disposedtrolley/etch-a-sketch/README.md

# etch-a-sketch

STM32-based Etch A Sketch widget with an OLED display and rotary encoders.

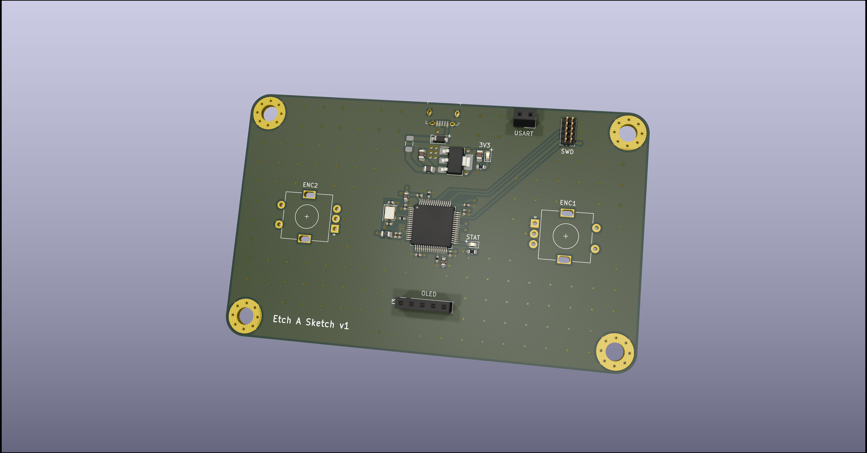
[picture p1: pcb.png]
PCB
