disposedtrolley/etch-a-sketch/Hardware/etch-a-sketch/etch-a-sketch.kicad_pcb

## KiCad design Hardware/etch-a-sketch/etch-a-sketch.kicad_pcb (2020-04-19)

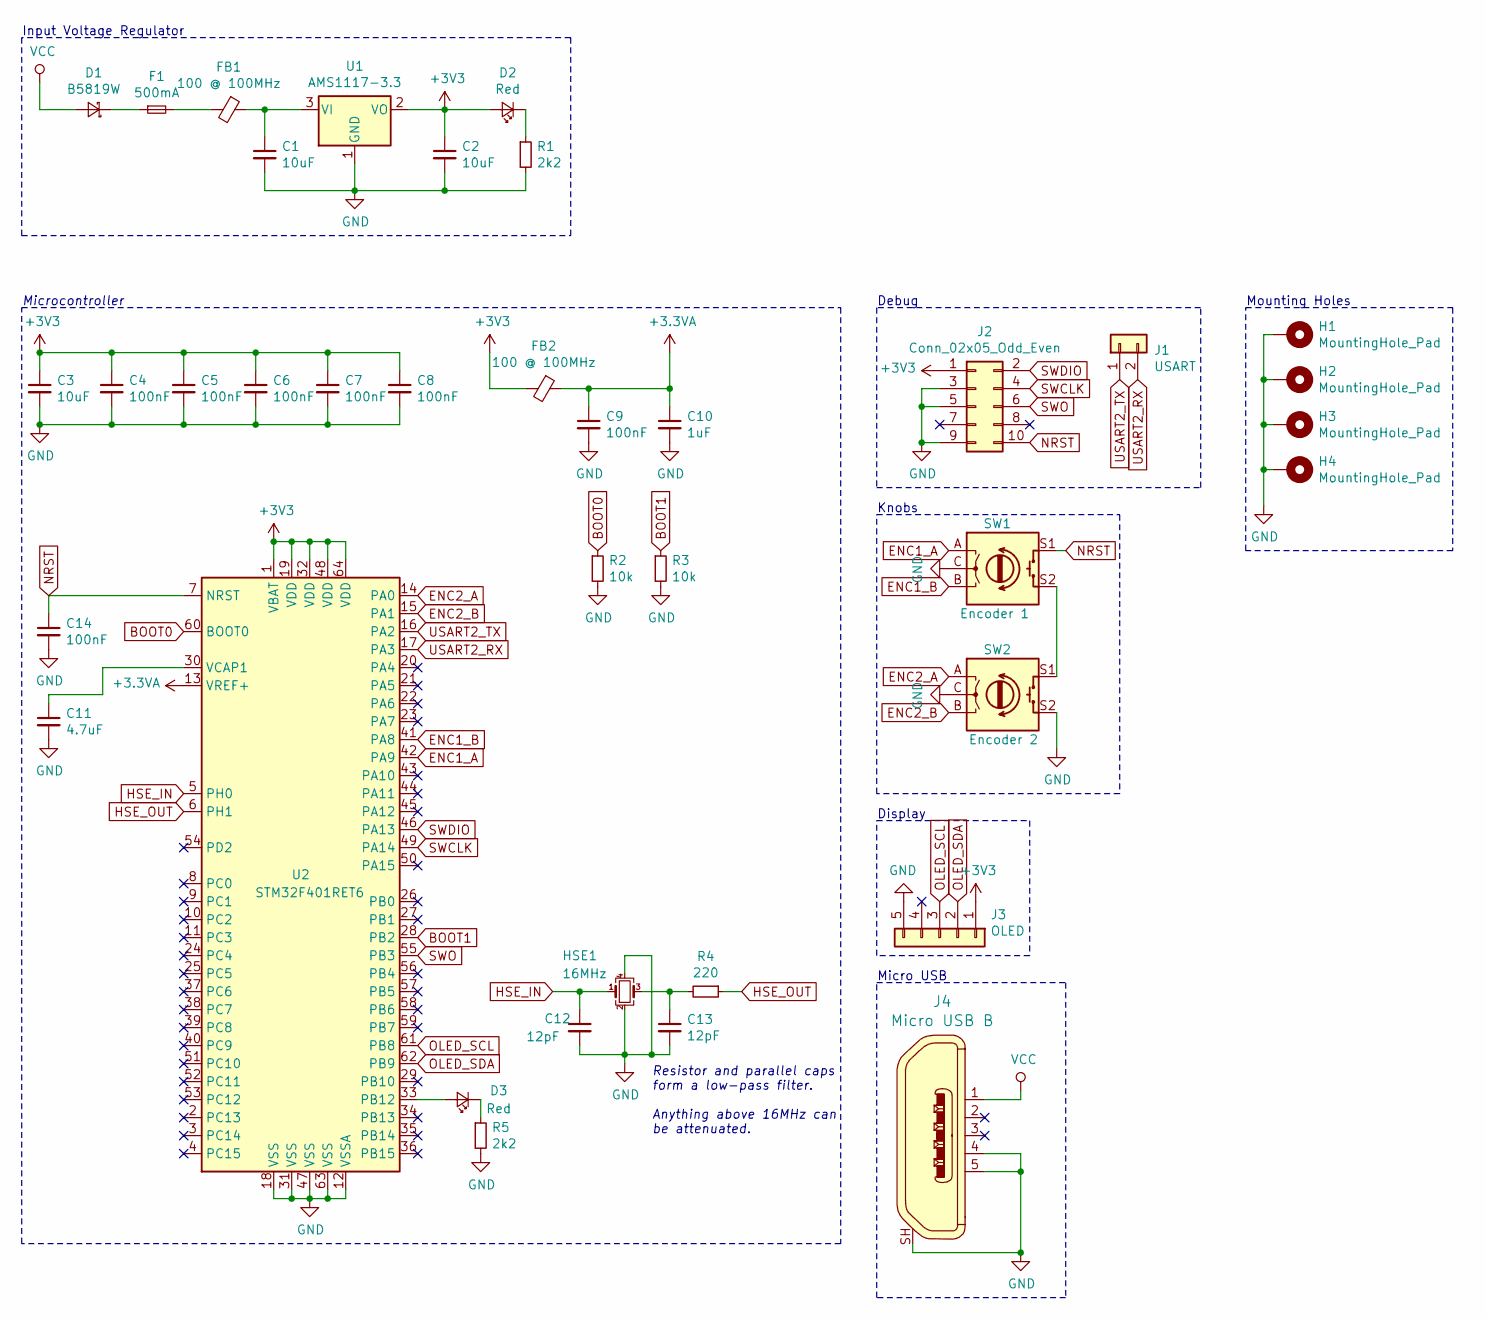
[picture p2: schematic etch-a-sketch.sch, Etch a Sketch]

Parts:
C1, C2: 10uF; C_0805_2012Metric
C3: 10uF; C_0603_1608Metric
C4, C5, C6, C7, C8, C9, C14: 100nF; C_0402_1005Metric
C10: 1uF; C_0402_1005Metric
C11: 4.7uF; C_0603_1608Metric
C12, C13: 12pF; C_0402_1005Metric
D1: B5819W; D_SOD-123
D2, D3: Red; LED_0603_1608Metric
F1: 500mA; Fuse_1206_3216Metric
FB1, FB2: 100 @ 100MHz; L_0805_2012Metric
H1, H2, H3, H4: MountingHole_Pad; MountingHole_4.3mm_M4_Pad_Via
HSE1: 16MHz; Crystal_SMD_3225-4Pin_3.2x2.5mm
J1: USART; PinSocket_1x02_P2.54mm_Vertical
J2: Conn_02x05_Odd_Even; PinHeader_2x05_P1.27mm_Vertical
J3: OLED; PinSocket_1x05_P2.54mm_Vertical
J4: Micro USB B; USB_Micro_B_Female_10118194-0001LF; MPN 10118194-0001LF; Digi-Key_PN 609-4618-1-ND
R1, R5: 2k2; R_0603_1608Metric
R2, R3: 10k; R_0402_1005Metric
R4: 220; R_0402_1005Metric
SW1: Encoder 1; RotaryEncoder_Alps_EC11E-Switch_Vertical_H20mm
SW2: Encoder 2; RotaryEncoder_Alps_EC11E-Switch_Vertical_H20mm
U1: AMS1117-3.3; SOT-223-3_TabPin2
U2: STM32F401RET6; LQFP-64_10x10mm_P0.5mm

Connections:
+3.3VA: C9.1, C10.1, FB2.1, U2.13 (VREF+)
+3V3: C2.1, C3.1, C4.1, C5.1, C6.1, C7.1, C8.1, D2.2 (A), FB2.2, J2.1, J3.1, U1.2 (VO), U2.1 (VBAT), U2.19 (VDD), U2.32 (VDD), U2.48 (VDD), U2.64 (VDD)
BOOT0: R2.1, U2.60 (BOOT0)
BOOT1: R3.1, U2.28 (PB2)
ENC1_A: SW1.A, U2.42 (PA9)
ENC1_B: SW1.B, U2.41 (PA8)
ENC2_A: SW2.A, U2.14 (PA0)
ENC2_B: SW2.B, U2.15 (PA1)
GND: C1.2, C2.2, C3.2, C4.2, C5.2, C6.2, C7.2, C8.2, C9.2, C10.2, C11.2, C12.2, C13.2, C14.2, H1.1, H2.1, H3.1, H4.1, HSE1.2, HSE1.4, J2.3, J2.5, J2.9, J3.5, J4.4, J4.5, J4.SH, R1.2, R2.2, R3.2, R5.2, SW1.C, SW2.C, SW2.S2, U1.1 (GND), U2.12 (VSSA), U2.18 (VSS), U2.31 (VSS), U2.47 (VSS), U2.63 (VSS)
HSE_IN: C12.1, HSE1.1, U2.5 (PH0)
HSE_OUT: R4.1, U2.6 (PH1)
NRST: C14.1, J2.10, SW1.S1, U2.7 (NRST)
unnamed: C1.1, FB1.1, U1.3 (VI)
unnamed: C11.1, U2.30 (VCAP1)
unnamed: C13.1, HSE1.3, R4.2
unnamed: D1.1 (K), F1.1
unnamed: D2.1 (K), R1.1
unnamed: D3.1 (K), R5.1
unnamed: D3.2 (A), U2.33 (PB12)
unnamed: F1.2, FB1.2
unnamed: SW1.S2, SW2.S1
OLED_SCL: J3.3, U2.61 (PB8)
OLED_SDA: J3.2, U2.62 (PB9)
SWCLK: J2.4, U2.49 (PA14)
SWDIO: J2.2, U2.46 (PA13)
SWO: J2.6, U2.55 (PB3)
USART2_RX: J1.2, U2.17 (PA3)
USART2_TX: J1.1, U2.16 (PA2)
VCC: D1.2 (A), J4.1

Notes on the sheet:
Input Voltage Regulator
Resistor and parallel caps form a low-pass filter. Anything above 16MHz can be attenuated.
Microcontroller
Debug
Display
Knobs
Mounting Holes
Micro USB

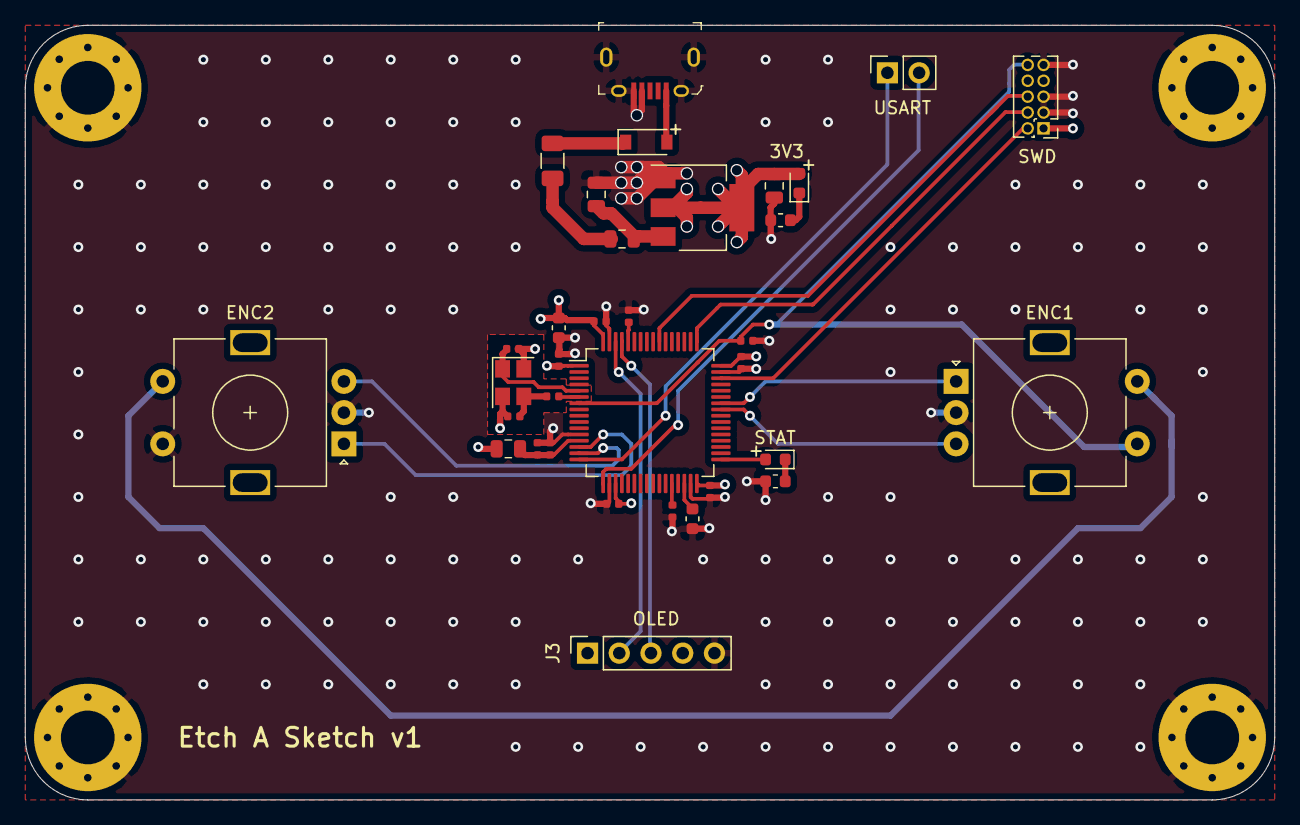
[picture p3: board etch-a-sketch.kicad_pcb from above]

Board: 4 copper layers, 100.0 x 62.0 mm, 38 parts (0 on the bottom side), 29 nets.
