disposedtrolley/etch-a-sketch/Firmware/Core/Src/main.c

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

/* Includes ------------------------------------------------------------------*/
#include "main.h"

/* USER CODE BEGIN Includes */
#include <errno.h>
#include <sys/unistd.h> // STDOUT_FILENO, STDERR_FILENO
#include <stdbool.h>
#include "lib/ssd1306/ssd1306.h"
/* USER CODE END Includes */

I2C_HandleTypeDef hi2c1;

TIM_HandleTypeDef htim1;
TIM_HandleTypeDef htim2;

UART_HandleTypeDef huart2;

/* USER CODE BEGIN PV */
volatile int x = 64;
volatile int y = 64;
volatile bool shouldDraw = false;
enum DrawDirection {
    Left,
    Right,
    Up,
    Down
};
volatile enum DrawDirection dir;

/* USER CODE END PV */

void SystemClock_Config(void);

static void MX_GPIO_Init(void);

static void MX_TIM1_Init(void);

static void MX_USART2_UART_Init(void);

static void MX_I2C1_Init(void);

static void MX_TIM2_Init(void);
/**
  * @brief  The application entry point.
  * @retval int
  */
int main(void) {
    /* MCU Configuration--------------------------------------------------------*/

    /* Reset of all peripherals, Initializes the Flash interface and the Systick. */
    HAL_Init();

    /* Configure the system clock */
    SystemClock_Config();

    /* Initialize all configured peripherals */
    MX_GPIO_Init();
    MX_TIM1_Init();
    MX_USART2_UART_Init();
    MX_I2C1_Init();
    MX_TIM2_Init();
    /* USER CODE BEGIN 2 */

    HAL_TIM_Encoder_Start_IT(&htim2, TIM_CHANNEL_1);
    HAL_TIM_Encoder_Start_IT(&htim1, TIM_CHANNEL_1);

    ssd1306_Init();
    ssd1306_Fill(Black);

    /* USER CODE END 2 */

    /* Infinite loop */
    /* USER CODE BEGIN WHILE */
    while (1) {
        if (shouldDraw) {
            printf("shouldDraw: x = %d y = %d\r\n", x, y);

            switch (dir) {
                case Left:
                    x -= 1;
                    break;
                case Right:
                    x += 1;
                    break;
                case Up:
                    y -= 1;
                    break;
                case Down:
                    y += 1;
                    break;
            }

            ssd1306_DrawPixel(x, y, White);
            ssd1306_UpdateScreen();

            shouldDraw = false;
        }
        /* USER CODE END WHILE */

        /* USER CODE BEGIN 3 */
    }
    /* USER CODE END 3 */
}

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
/* USER CODE BEGIN 4 */

void HAL_TIM_IC_CaptureCallback(TIM_HandleTypeDef *htim) {
    if (htim->Instance == TIM1) {
        // X axis
        int16_t count = TIM1->CNT;
        int rawDir = (TIM1->CR1 >> 4UL) & 0x1UL;

        dir = rawDir > 0 ? Left : Right;

        printf("X :: count: %d rawDir: %d\r\n", count / 2, rawDir);

        shouldDraw = true;
    }

    if (htim->Instance == TIM2) {
        // Y axis
        int16_t count = TIM2->CNT;
        int rawDir = (TIM2->CR1 >> 4UL) & 0x1UL;

        dir = rawDir > 0 ? Down : Up;

        printf("Y :: count: %d rawDir: %d\r\n", count / 2, rawDir);

        shouldDraw = true;
    }
}

/**
 * Overrides the built-in _write method to redirect output to UART2
 * for debugging.
 *
 * https://electronics.stackexchange.com/a/279945
 */
int _write(int file, char *data, int len) {
    if ((file != STDOUT_FILENO) && (file != STDERR_FILENO)) {
        errno = EBADF;
        return -1;
    }

    // arbitrary timeout 1000
    HAL_StatusTypeDef status = HAL_UART_Transmit(&huart2, (uint8_t *) data, len,
                                                 1000);

    // return # of bytes written - as best we can tell
    return (status == HAL_OK ? len : 0);
}

/* USER CODE END 4 */
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
