disposedtrolley/etch-a-sketch/Firmware/Firmware.ioc

Mcu.UserName=STM32F401RETx
PA14.GPIO_Label=TCK
PA0-WKUP.Signal=S_TIM2_CH1_ETR
PA13.Signal=SYS_JTMS-SWDIO
PA9.Signal=S_TIM1_CH2
PA1.Signal=S_TIM2_CH2
PA8.Signal=S_TIM1_CH1
PA2.Signal=USART2_TX
PA13.GPIO_Label=TMS
PB3.Signal=SYS_JTDO-SWO
PB9.Signal=I2C1_SDA
PA14.Signal=SYS_JTCK-SWCLK
PB8.Signal=I2C1_SCL
PB12.Signal=GPIO_Output
PA3.Signal=USART2_RX
PB3.GPIO_Label=SWO
