disposedtrolley/etch-a-sketch/(commit log)

2020-03-08 feat: redirect _write to uart2
2020-03-08 wip: working state
    This commit brings the encoder value reading to a working state, however
    it uses a combination of GUI setup (generated code) and custom setup
    logic to properly configure and initialise the GPIO pins and Timer
    peripheral to work correctly with a rotary encoder.
    The setup logic should be moved exclusively into user code so nothing
    important becomes buried.
    [main.c]
2020-03-09 refactor: change encoder mode to TI1
    Seems to work fine with one channel. Detects direction and also means
    the count only needs to be divided by 2 instead of 4.
2020-03-09 feat: configure GPIO via code, start timer using the HAL method
2020-03-09 feat: divide count by 2, get dir from CR1, print both
2020-03-14 chore: remove header noise, add LICENSE
    [DEV_Config.h]
2020-03-15 feat: set encoder to trigger an interrupt
2020-03-21 fix: move global vars into user code block
    [main.c]
2020-03-21 feat: add direction, draw only when rotary encoder has been turned
2020-03-28 feat: remove epaper dependencies and SPI config
2020-03-28 feat: add I2C config and OLED driver lib
2020-03-28 feat: remove #defines in lib to force I2C, add lib to include dirs, run tests
2020-03-29 feat: draw on x-axis when encoder is turned
2020-03-29 feat: enable TIM3 for second rotary encoder
2020-04-13 feat: initial attempt
    [etch-a-sketch.kicad_pcb, etch-a-sketch.sch]
2020-04-13 feat: redo main schematic design
    [etch-a-sketch.sch]
2020-04-13 feat: add OLED and encoders
    [etch-a-sketch.sch]
2020-04-13 feat: add status LED to PB12
    [etch-a-sketch.sch]
2020-04-13 feat: add power LED
    [etch-a-sketch.sch]
2020-04-13 feat: organise schematic into blocks
    [etch-a-sketch.sch]
2020-04-13 feat: add USART to PA2 and PA3, change OLED to generic connector
    [etch-a-sketch.sch]
2020-04-13 feat: add micro USB connector
    [etch-a-sketch.sch]
2020-04-13 fix: micro USB should provide VCC in
    [etch-a-sketch.sch]
2020-04-13 feat: assign all footprints
    [etch-a-sketch.sch]
2020-04-13 feat: add PCB outline and import netlist
    [etch-a-sketch.kicad_pcb]
2020-04-13 feat: position mounting holes
    [etch-a-sketch.kicad_pcb]
2020-04-13 feat: add rounded corners to PCB outline
    [etch-a-sketch.kicad_pcb]
2020-04-13 fix: resize PCB outline to be 62mm tall
    [etch-a-sketch.kicad_pcb]
2020-04-13 feat: move MCU to centre of board
    [etch-a-sketch.kicad_pcb]
2020-04-13 feat: associate correct footprint for OLED connector
    [etch-a-sketch.kicad_pcb, etch-a-sketch.sch]
2020-04-13 fix: actually maybe better to keep the OLED socketed
    [etch-a-sketch.kicad_pcb, etch-a-sketch.sch]
2020-04-13 feat: place HSE
    [etch-a-sketch.kicad_pcb]
2020-04-13 feat: add decoupling capacitors
    [etch-a-sketch.kicad_pcb]
2020-04-14 feat: place encoders, refine placement of power regulator
    [etch-a-sketch.kicad_pcb]
2020-04-14 feat: place OLED socket
    [etch-a-sketch.kicad_pcb]
2020-04-14 feat: place debug connectors and resistor for power regulator
    [etch-a-sketch.kicad_pcb]
2020-04-14 feat: place status LED
    [etch-a-sketch.kicad_pcb]
2020-04-14 feat: finalise layout
    [etch-a-sketch.kicad_pcb]
2020-04-14 refactor: reposition encoders
    - Move ENC2 to use PA0 and PA2 so they don't need to cross to the other
    side of the MCU.
    - Swap ENC1's A and B pins so they don't cross each other.
    [etch-a-sketch.kicad_pcb, etch-a-sketch.sch]
2020-04-17 feat: configure board
    [etch-a-sketch.kicad_pcb]
2020-04-17 feat: add GND and 3v3 fills to all layers
    [etch-a-sketch.kicad_pcb]
2020-04-17 feat: route oscillator and refine fills
    [etch-a-sketch.kicad_pcb]
2020-04-17 feat: add small trace between osc fill and In1.Cu full
    [etch-a-sketch.kicad_pcb]
2020-04-17 feat: route power
    [etch-a-sketch.kicad_pcb]
2020-04-17 feat: complete initial routing
    [etch-a-sketch.kicad_pcb]
2020-04-18 feat: add silkscreen labels
    [etch-a-sketch.kicad_pcb]
2020-04-18 feat: add labels for power, status LED, and connectors
    [etch-a-sketch.kicad_pcb]
2020-04-18 feat: add polarity and pin 1 markers
    [etch-a-sketch.kicad_pcb]
2020-04-18 refactor: refine ground fill for oscillator
    [etch-a-sketch.kicad_pcb]
2020-04-18 feat: add title
    [etch-a-sketch.kicad_pcb]
2020-04-18 feat: move USART to top, rearrange encoder 2 pins
    [etch-a-sketch.kicad_pcb, etch-a-sketch.sch]
2020-04-18 fix: swap encoder labels
    [etch-a-sketch.kicad_pcb]
2020-04-18 refactor: place title on bottom-left
    [etch-a-sketch.kicad_pcb]
2020-04-18 fix: connect oscillator ground plane to ground
    [etch-a-sketch.kicad_pcb]
2020-04-18 feat: add via stitching
    [etch-a-sketch.kicad_pcb]
2020-04-18 docs: update README with pcb render
2020-04-18 fix: enable back layers, clean up USB ground traces
    [etch-a-sketch.kicad_pcb]
2020-04-18 feat: generate gerbers, BOM, and position files
    [bom.csv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]
2020-04-18 fix: adjust orientation of MCU and voltage regulator
    [etch-a-sketch-all-pos.csv]
2020-04-18 feat: change micro USB footprint to 10118194
    [etch-a-sketch.kicad_pcb, etch-a-sketch.sch]
2020-04-18 feat: adjust connector position according to datasheet
    [etch-a-sketch.kicad_pcb]
2020-04-18 feat: route connector pins
    [etch-a-sketch.kicad_pcb]
2020-04-18 feat: update position and overall BOM
    [bom.csv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]
2020-04-18 feat: update gerbers
    [etch-a-sketch-B_Cu.gbr, etch-a-sketch-B_Mask.gbr, etch-a-sketch-B_Paste.gbr, etch-a-sketch-B_SilkS.gbr, etch-a-sketch-Edge_Cuts.gbr, etch-a-sketch-F_Cu.gbr, etch-a-sketch-F_Mask.gbr, etch-a-sketch-F_Paste.gbr]
2020-04-18 fix: wrong rotations
    [etch-a-sketch-all-pos.csv]
2020-04-18 feat: change SWD connector to through-hole
    [etch-a-sketch.kicad_pcb, etch-a-sketch.sch]
2020-04-18 feat: update pos and overall BOM
    [bom.csv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]
2020-04-18 feat: regenerate drill and gerbers
    [etch-a-sketch-B_Cu.gbr, etch-a-sketch-B_Mask.gbr, etch-a-sketch-B_Paste.gbr, etch-a-sketch-B_SilkS.gbr, etch-a-sketch-Edge_Cuts.gbr, etch-a-sketch-F_Cu.gbr, etch-a-sketch-F_Mask.gbr, etch-a-sketch-F_Paste.gbr]
2020-04-18 fix: correct rotation of MCU and voltage regulator
    [etch-a-sketch-all-pos.csv]
2020-04-18 feat: add polarity for schottky diode, move pin marker for USB port
    [etch-a-sketch-B_Cu.gbr, etch-a-sketch-B_Mask.gbr, etch-a-sketch-B_Paste.gbr, etch-a-sketch-B_SilkS.gbr, etch-a-sketch-Edge_Cuts.gbr, etch-a-sketch-F_Cu.gbr, etch-a-sketch-F_Mask.gbr, etch-a-sketch-F_Paste.gbr]
2020-04-19 feat: connect encoder switches to act as NRST button
    [etch-a-sketch.sch]
2020-04-19 feat: route encoder buttons to NRST, add decoupling capacitor
    [etch-a-sketch.kicad_pcb, etch-a-sketch.sch]
2020-04-19 refactor: shorten route of ENC2 A and B
    [etch-a-sketch.kicad_pcb]
2020-04-19 feat: update gerbers, drill, BOM, and position files
    [bom.csv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]
2020-04-19 refactor: move NRST decoupling capacitor close to MCU
    [etch-a-sketch.kicad_pcb, etch-a-sketch.sch]
2020-04-19 feat: update PCB render
2020-05-02 feat: disable pushbutton pin
2020-05-02 fix: HSE clock, TIM2 for encoder, PB12 for status LED
    [Firmware.ioc, main.c]
